kflu/vem/doc/README.md

[temperature.log](temperature.log): 9v battery test raw data
