kflu/vem/(threads)

Thread 2 (2017-05-02):

Use reference voltage for temperature sensor

kflu, 2017-05-02:
9v battery voltage gradually goes down on 5V output.

TODO:
* [Use voltage reference][1]
    * [analogReference][2]
* Have voltage self monitoring and sending warning when dropped below 5v?
* Use a different power source for temperature sensor (drain less)?
* Use USB power which is regulated? Use constant car power?

[1]: https://learn.adafruit.com/tmp36-temperature-sensor/using-a-temp-sensor#getting-better-precision
[2]: https://www.arduino.cc/en/Reference/analogReference
